nestik83/alilo/README.md

# Alilo 3.0 🎵✨

Улучшенная версия интерактивного зайчика Alilo на базе **LGT8F328P**.  
Игрушка совмещает музыкальные и обучающие функции, ночник и развивающие режимы.  
Проект создан для расширения возможностей оригинальной игрушки и полностью настраиваемый.

---

## 📂 Структура папок для microSD

Поместите файлы на карту памяти microSD в соответствии с папками:

- **01** — Песни  
- **02** — Сказки  
- **03** — Музыка для сна  
- **04** — Звуки погремушки  
- **05** — Названия цветов  
- **07** — Системные звуки (служебные эффекты, включение/выключение и пр.)

---

## ⚙️ Функции проекта

- 🎶 Воспроизведение музыки и сказок.  
- 🌙 Музыка для сна и ночник с плавным переливанием цветов.  
- 🎨 Обучение названиям цветов.  
- 🥁 Режим погремушки с забавными звуками.  
- 🔋 Контроль питания, автоотключение при разряде.  
- 💾 Сохранение режима и громкости в EEPROM.  
- 🎛 Регулировка громкости потенциометром.  
- 🌈 Световая FFT-визуализация под музыку.  

---

## 🔧 Аппаратная часть

- Контроллер: **LGT8F328P**  
- Динамик  
- RGB-светодиоды для подсветки и определения цвета
- Фототранзистор для определения отражения цвета  
- Кнопка на животике (смена режима)  
- Мембранная кнопка (определение цвета при нажатии на игрушку)  
- DFPlayer Mini для воспроизведения MP3  
- Li-Ion аккумулятор
- Датчик вибрации  

---

## 🚀 Установка

1. Скопируйте прошивку на плату **LGT8F328P**.  
2. Запишите аудиофайлы на microSD в соответствующие папки.  
3. Вставьте карту памяти в DFPlayer.  
4. Подключите питание и наслаждайтесь работой Alilo 3.0! 🎉
