nestik83/alilo/Инструкция Зайчик Alilo.docx

# 🐇 Зайчик Alilo 3.0

Руководство для родителей

## Назначение игрушки

Зайчик Alilo 3.0 — это интерактивная музыкальная игрушка: он умеет проигрывать песенки и сказки, реагировать на встряхивание как погремушка, определять цвета входящих в комплект карточек, а также использоваться как ночник.

## Элементы управления

- Кнопка MODE (кнопка на животике) — отвечает за переключение режимов и переключение треков.
- Кнопка COLOR (поставить зайчика на поверхность и слегка надавить) — отвечает за распознавание цветов и калибровку.
- Датчик вибрации — встроен в игрушку, срабатывает, когда ребёнок трясёт Зайчика.
- Подсветка ушей — изменяет цвет в зависимости от музыки, режима или выбранного эффекта.
- Разъём питания (Type-C) — для зарядки.

## Режимы работы

Игрушка имеет 5 режимов, которые переключаются долгим нажатием кнопки MODE (удерживать ~1 сек.), и 6 – ой режим ночника при убавленной до нуля громкости:

1. 🎵 Режим песенок (Папка 01)
  - Воспроизводятся детские песенки.
  - Короткое нажатие на кнопку MODE переключает следующий трек.
  - Двойное короткое нажатие включает режим повтора играющего трека, включение режима отображается четырехкратным миганием зеленого цвета. Трек будет повторятся до переключения на следующий коротким нажатием кнопки.
2. 📖 Режим сказок (Папка 02)
  - Воспроизводятся аудиосказки.
  - Короткое нажатие переключает следующую сказку.
  - Двойное короткое нажатие включает режим повтора играющего трека, включение режима отображается четырехкратным миганием зеленого цвета. Трек будет повторятся до переключения на следующий коротким нажатием кнопки.
3. 🌙 Режим музыка для сна (Папка 03)
  - Воспроизводятся спокойные мелодии способствующие засыпанию
  - Короткое нажатие переключает следующий трек.
  - Двойное короткое нажатие включает режим повтора играющего трека, включение режима отображается четырехкратным миганием зеленого цвета. Трек будет повторятся до переключения на следующий коротким нажатием кнопки.
4. 🎲 Режим погремушки (Папка 04)
  - Когда ребёнок трясёт игрушку, включаются специальные короткие звуки (папка 04). Алфавит.
  - При постоянном потрясывании игрушка повторяет звук 3 раза далее переходит к следующему.
  - Подсветка загорается случайным цветом до следующего встряхивания.
5. Режим изучение цветов (Папка 05)
  - Установите Зайчика на карточку Зайчик распознает цвет и зажгет ушки в цвет карточки произнеся название цвета на русском и английском языках.
  - В случае неправильного определения или не определения, цвета необходимо откалибровать (см. Ниже).
6. Режим ночника

Режим активируется автоматически при нулевой громкости, световые эффекты переключаются коротким нажатием на кнопку MODE.

Эффекты:

1. Плавное переливание цветов.
2. Белый свет.
3. Красный свет.
4. Зеленый свет.
5. Синий свет.

## Дополнительные функции

- 🔋 Контроль питания
  - При низком заряде батареи (ниже 3.3 В) Зайчик мигает красным и предупреждает звуком.
  - При зарядке мигает зелёным, при полной зарядке горит зелёный постоянно.
- 💾 Запоминание состояния
  - Игрушка запоминает, в каком режиме и на каком треке она остановилась, даже если выключить питание.
- 😴 Автоматический сон
  - Если игрушку не трогать 40 минут, она засыпает для экономии заряда батареи.
  - Разбудить можно нажатием и удержанием более 2 сек кнопки MODE или подключением зарядки.

## Калибровка цветов

(для родителей, если цвета определяются некорректно, или совсем не определяются)

Калибровку необходимо проводить на не полностью заряженной игрушке. Разрядить, поставить на зарядку на ~5 минут, приступить к калибровке. Если откалибровать на полностью заряженной игрушке, то к моменту разряда возможно не корректное определение цветов.

1. Выключите игрушку поворотом ручки регулировки громкости.
2. Нажмите и удерживайте кнопку COLOR (кольцо на нижней стороне Зайчика).
3. Одновременно удерживайте кнопку MODE.
4. Включите питание Зайчика поворотом ручки регулировки громкости не отпуская кнопок. Через две секунды Зайчик перейдет в режим калибровки три раза мигнув синим цветом. Можно отпустить кнопки.
5. Поставте Зайчика на карточку с первым калибруемым цветом Черным и нажмите кнопку MODE, в случае успешного определения цвета зайчик три раза мигнет зеленым и перейдет к калибровке следующего цвета подсветив ушки нужным цветом, в случае если определенный цвет уже имеется в памяти, Зайчик мигнет три раза крассным и будет ожидать повторного нажатия MODE с правильно установленным цветом.
6. Проделайте так со всеми цветами в указанном порядке (1 - чёрный, 2 - синий, 3 - зелёный, 4 - фиолетовый, 5 - красный, 6 - белый, 7 - жёлтый, 8 - серый, 9 – оранжевый).
7. По окончанию калибровки выключите и включите Зайчика.

Калибровку необходимо пройти полностью, так как при начале калибровки цвета из памяти удаляются. В случае не полного прохождения калибровки определение цветов будет работать не корректно. В случае не полной калибровки, процедуру необходимо повторить сначала, выключив Зайчика.

## Загрузка контента

Для загрузки контента необходимо получить доступ к microSD карте находящейся в голове игрушки, для этого снимите силиконовый капюшон потянув за ушки Зайчика, открутите два винта и снимите верхнюю половинку головы придерживая нижнюю. Далее аккуратно вытащите SD карту нажатием на нее до упора и отпусканием пока карточка не отщелкнится.

Далее загрузите контент на карточку используя имеющиеся средства (телефон, картридер, слот для microSD на ноутбуке и т.д.)

Соберите игрушку в обратном порядке.

Контент загружается в определенные для режимов папки (см. “Режимы” выше)

Дополнить контент нельзя, возможна только замена оригинального контента своим, названия файлов могут быть любыми но должны начинаться с цифровой последовательности 001., 002. и так далее. Игрушка будет воспроизводить контент в указанном порядке.

Изменение названия папок не допускается. Изменение количества файлов не допускается.

Поддерживаемые форматы файлов mp3 и wav.

## Советы по использованию

- Игрушка рассчитана для детей от 1 года (под присмотром взрослых).
- Не оставляйте игрушку под дождём или в воде.
- Заряжайте только стандартным USB-кабелем от адаптера 5 В, или от USB порта компьютера.
- Если игрушка не реагирует — возможно, батарея полностью разряжена. Поставьте на зарядку на 30–40 минут.

## Быстрый справочник для родителей

- Короткое нажатие MODE → следующий трек (в режимах 1–5) или смена цвета (в ночном режиме).
- Двойное короткое нажатие MODE → режим повтора играющего трека в режимах (1-3).
- Долгое нажатие MODE → переключение режима.
- Кнопка COLOR (кольцо на нижней стороне игрушки) → определение цвета или вход в режим калибровки цветов.
- Трясти игрушку → звуки погремушки.
