nestik83/alilo/Schematic_Alilo_2025-09-01.pdf

## Charging board

## Head board

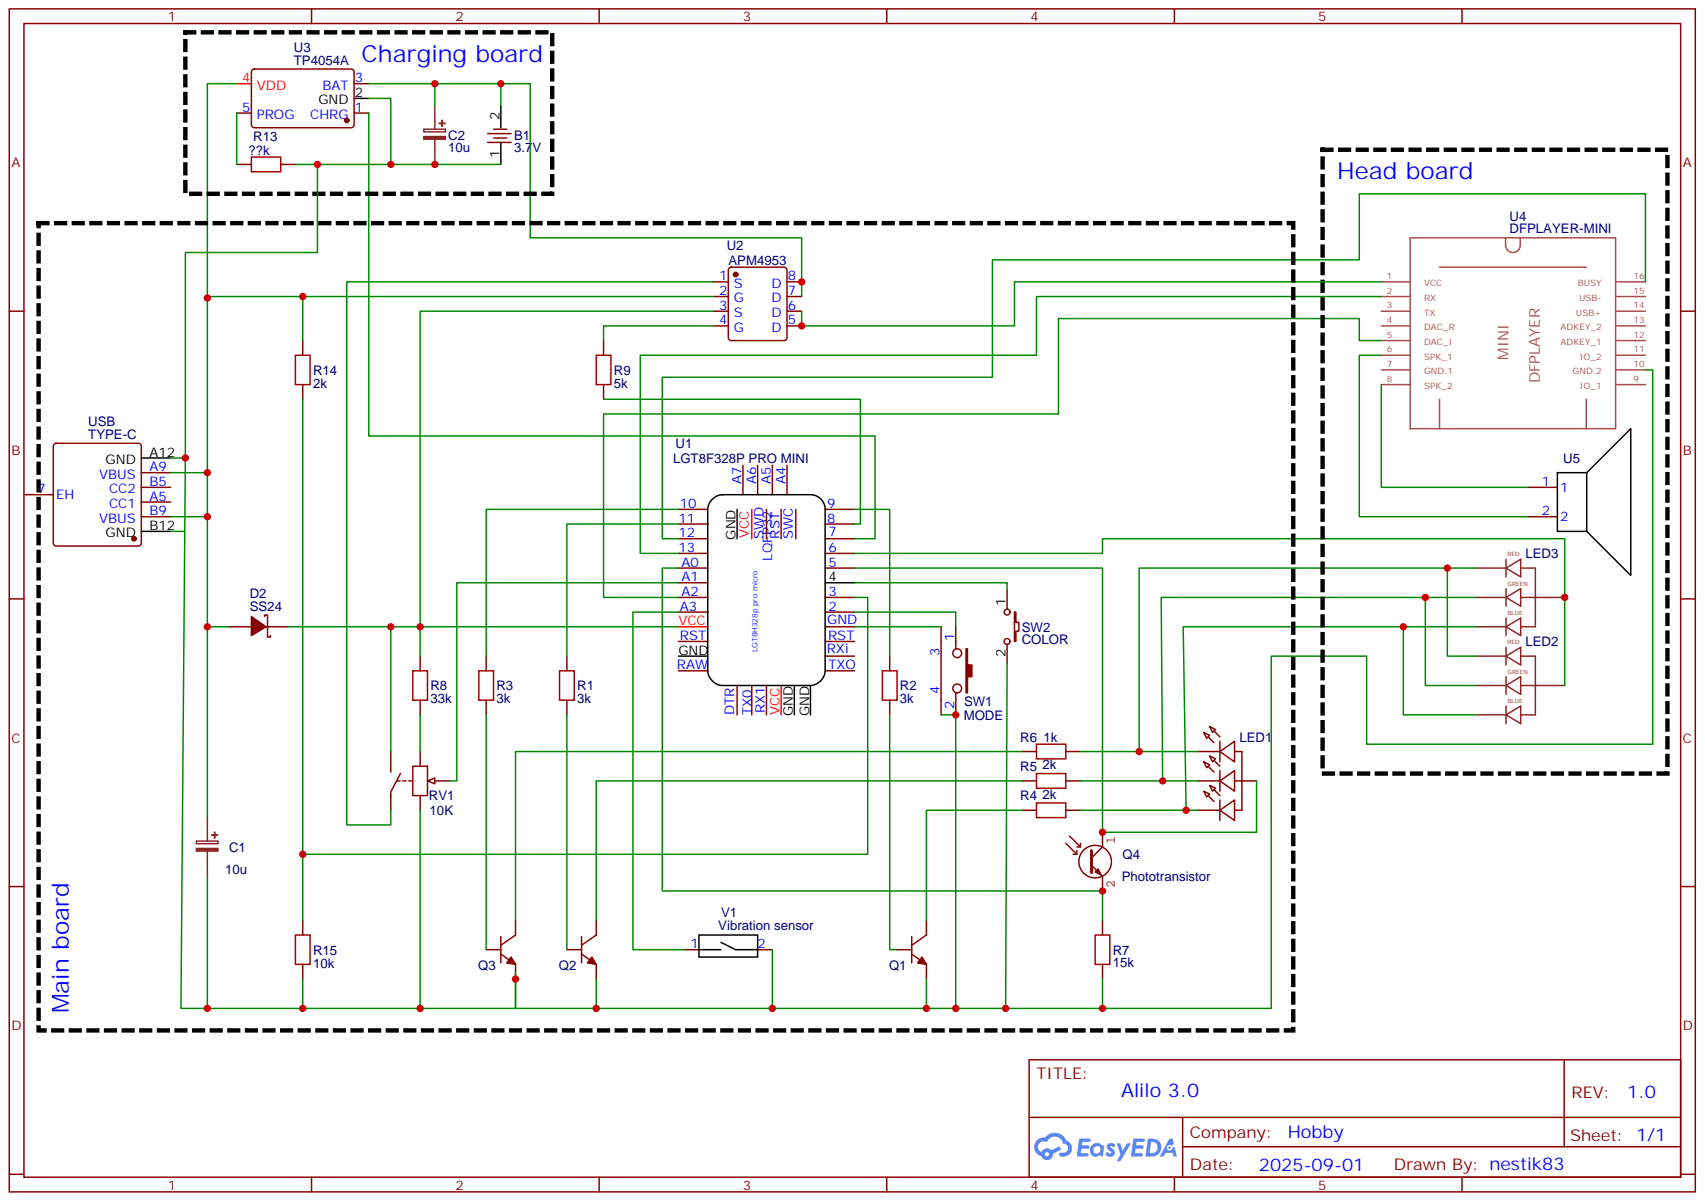
[picture p1: page 1]
