nestik83/alilo/(commit log)

2025-08-22 Add folder auto arduino
2025-08-22 Remove led off after vibration stop
    [Alilo.ino]
2025-08-23 Create Инструкция Зайчик Alilo.docx
2025-08-24 Addet charging module and charging control
2025-08-25 change battery control
2025-09-01 Added schematic
